tomwimmenhove/NerdClock/README.md

# NerdClock
7-Segment display using an LED and a 3-phase motor

See https://youtu.be/A6WD372-6BQ for a video of it running
