tomwimmenhove/NerdClock/hardware/Drawings/s-l1600 (UV LED).jpg

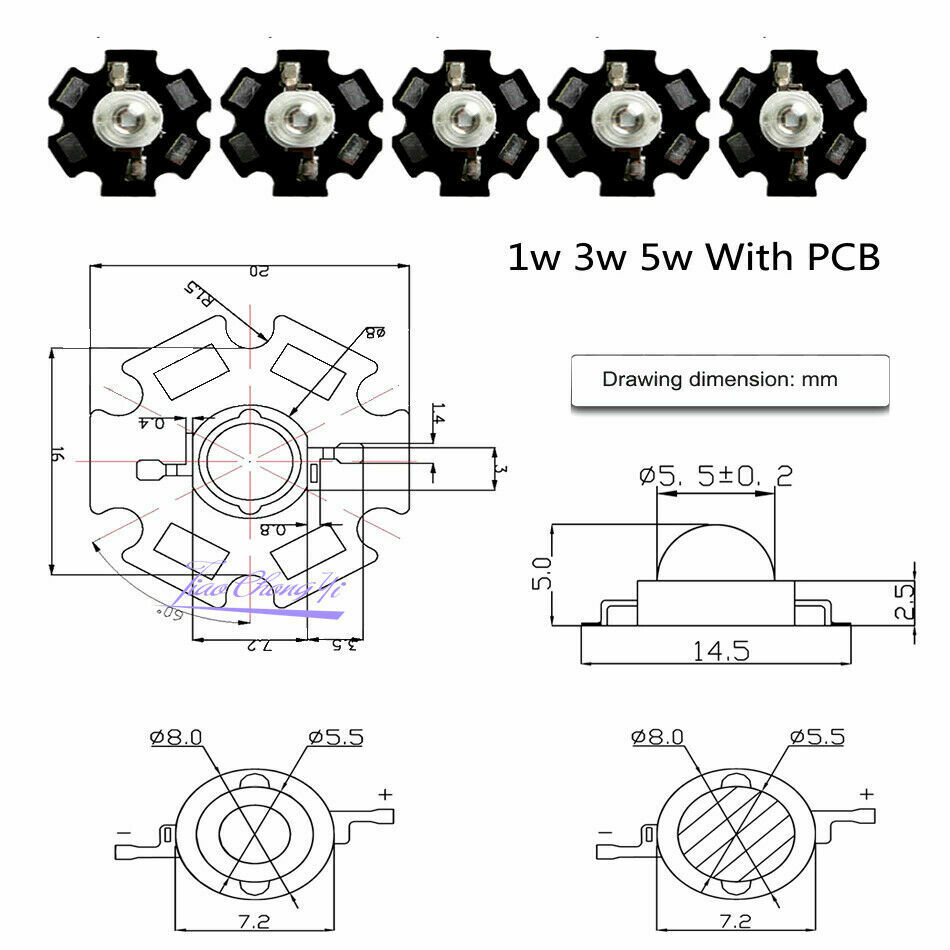
hardware/Drawings/s-l1600 (UV LED).jpg
