tomwimmenhove/NerdClock/hardware/NerdClock/NerdClock.kicad_pcb

## KiCad design hardware/NerdClock/NerdClock.kicad_pcb (2021-07-23)

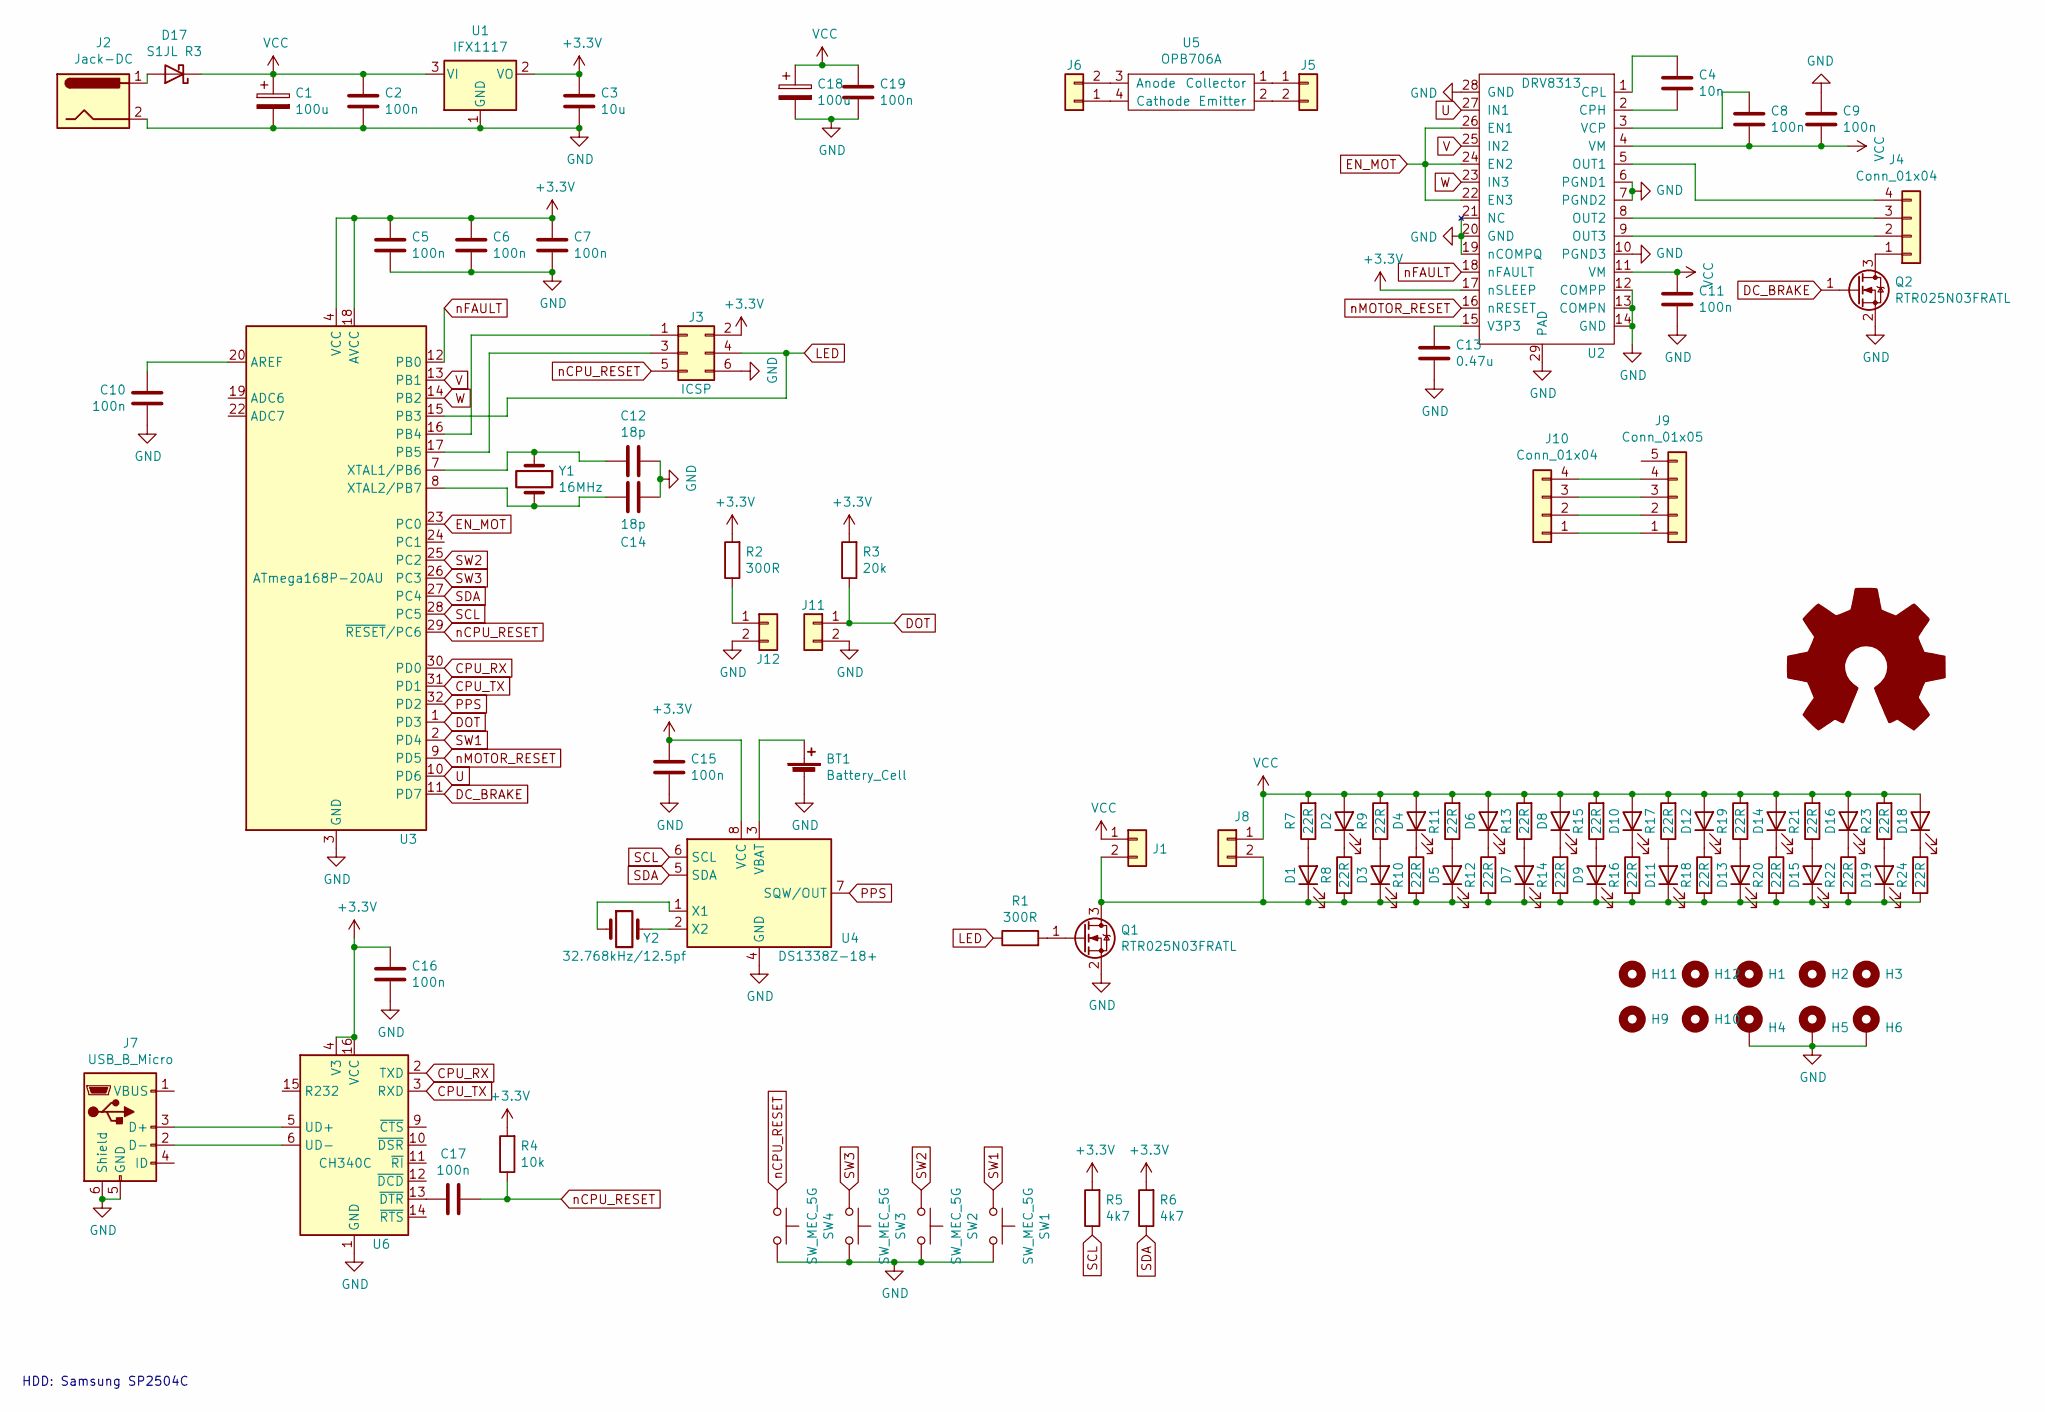
[picture p2: schematic NerdClock.sch]

Parts:
BT1: Battery_Cell; BatteryHolder_Keystone_1060_1x2032
C1, C18: 100u; CP_Elec_5x5.4
C2, C5, C6, C7, C8, C9, C10, C11, C15, C16, C17, C19: 100n; C_0603_1608Metric
C3: 10u; C_0603_1608Metric
C4: 10n; C_0603_1608Metric
C12, C14: 18p; C_0603_1608Metric
C13: 0.47u; C_0603_1608Metric
D1, D2, D3, D4, D5, D6, D7, D8, D9, D10, D11, D12, D13, D14, D15, D16, D18, D19: LED; WhiteLed1W
D17: S1JL R3; D_SMA
H1, H2, H3, H9, H10, H11, H12: MountingHole; MountingHole_3.2mm_M3
H4, H5, H6: MountingHole_Pad; MountingHole_3.2mm_M3_Pad_Via
J1, J5, J6, J11, J12: Conn_01x02; PinHeader_1x02_P2.54mm_Vertical
J2: Jack-DC; BarrelJack_Wuerth_6941xx301002
J3: ICSP; PinHeader_2x03_P2.54mm_Vertical
J4, J10: Conn_01x04; PinHeader_1x04_P2.54mm_Vertical
J7: USB_B_Micro; USB_Micro-B_Amphenol_10103594-0001LF_Horizontal
J8: Conn_01x02; PinHeader_2x01_P2.54mm_Vertical_SMD
J9: Conn_01x05; MotorConn
Q1, Q2: RTR025N03FRATL; SOT-23
R1, R2: 300R; R_0603_1608Metric
R3: 20k; R_0603_1608Metric
R4: 10k; R_0603_1608Metric
R5, R6: 4k7; R_0603_1608Metric
R7, R8, R9, R10, R11, R12, R13, R14, R15, R16, R17, R18, R19, R20, R21, R22, R23, R24: 22R; R_0603_1608Metric
SW1, SW2, SW3, SW4: SW_MEC_5G; SW_SPST_Omron_B3FS-100xP
U1: IFX1117; SOT-223-3_TabPin2
U2: DRV8313; HTSSOP-28-1EP_4.4x9.7mm_P0.65mm_EP3.4x9.5mm_ThermalVias
U3: ATmega168P-20AU; TQFP-32_7x7mm_P0.8mm
U4: DS1338Z-18+; SOIC-8_3.9x4.9mm_P1.27mm
U5: OPB706A
U6: CH340C; SOIC-16_3.9x9.9mm_P1.27mm
Y1: 16MHz; Crystal_SMD_ECS_CSM3X-2Pin_7.6x4.1mm
Y2: 32.768kHz/12.5pf; Crystal_C26-LF_D2.1mm_L6.5mm_Horizontal

Connections:
+3V3: C3.1, C5.1, C6.1, C7.1, C15.1, C16.1, J3.2, R2.2, R3.2, R4.2, R5.2, R6.2, U1.2 (VO), U2.17 (nSLEEP), U3.4 (VCC), U3.6 (VCC), U3.18 (AVCC), U4.8 (VCC), U6.4 (V3), U6.16 (VCC)
CPU_RX: U3.30 (PD0), U6.2 (TXD)
CPU_TX: U3.31 (PD1), U6.3 (RXD)
DC_BRAKE: Q2.1 (G), U3.11 (PD7)
DOT: J11.1, R3.1, U3.1 (PD3)
EN_MOT: U2.22 (EN3), U2.24 (EN2), U2.26 (EN1), U3.23 (PC0)
GND: BT1.2 (-), C1.2, C2.2, C3.2, C5.2, C6.2, C7.2, C9.1, C10.1, C11.2, C12.2, C13.2, C14.2, C15.2, C16.2, C18.2, C19.2, H4.1, H5.1, H6.1, J2.2, J3.6, J7.5 (GND), J7.6 (Shield), J11.2, J12.2, Q1.2 (S), Q2.2 (S), SW1.3 (B), SW1.4 (B), SW2.3 (B), SW2.4 (B), SW3.3 (B), SW3.4 (B), SW4.3 (B), SW4.4 (B), U1.1 (GND), U2.6 (PGND1), U2.7 (PGND2), U2.10 (PGND3), U2.12 (COMPP), U2.13 (COMPN), U2.14 (GND), U2.19 (nCOMPQ), U2.20 (GND), U2.21 (NC), U2.28 (GND), U2.29 (PAD), U3.3 (GND), U3.5 (GND), U3.21 (GND), U4.4 (GND), U6.1 (GND)
LED: J3.4, R1.1, U3.15 (PB3)
unnamed: BT1.1 (+), U4.3 (VBAT)
unnamed: C4.1, U2.1 (CPL)
unnamed: C4.2, U2.2 (CPH)
unnamed: C8.1, U2.3 (VCP)
unnamed: C10.2, U3.20 (AREF)
unnamed: C12.1, U3.7 (XTAL1/PB6), Y1.1
unnamed: C13.1, U2.15 (V3P3)
unnamed: C14.1, U3.8 (XTAL2/PB7), Y1.2
unnamed: C17.2, U6.13 (~DTR)
unnamed: D1.1 (K), D3.1 (K), D5.1 (K), D7.1 (K), D9.1 (K), D11.1 (K), D13.1 (K), D15.1 (K), D19.1 (K), J1.2, J8.2, Q1.3 (D), R8.2, R10.2, R12.2, R14.2, R16.2, R18.2, R20.2, R22.2, R24.2
unnamed: D1.2 (A), R7.1
unnamed: D2.1 (K), R8.1
unnamed: D3.2 (A), R9.1
unnamed: D4.1 (K), R10.1
unnamed: D5.2 (A), R11.1
unnamed: D6.1 (K), R12.1
unnamed: D7.2 (A), R13.1
unnamed: D8.1 (K), R14.1
unnamed: D9.2 (A), R15.1
unnamed: D10.1 (K), R16.1
unnamed: D11.2 (A), R17.1
unnamed: D12.1 (K), R18.1
unnamed: D13.2 (A), R19.1
unnamed: D14.1 (K), R20.1
unnamed: D15.2 (A), R21.1
unnamed: D16.1 (K), R22.1
unnamed: D17.2 (A), J2.1
unnamed: D18.1 (K), R24.1
unnamed: D19.2 (A), R23.1
unnamed: J3.1, U3.16 (PB4)
unnamed: J3.3, U3.17 (PB5)
unnamed: J4.1, Q2.3 (D)
unnamed: J4.2, U2.9 (OUT3)
unnamed: J4.3, U2.8 (OUT2)
unnamed: J4.4, U2.5 (OUT1)
unnamed: J5.1, U5.1 (Collector)
unnamed: J5.2, U5.2 (Emitter)
unnamed: J6.1, U5.4 (Cathode)
unnamed: J6.2, U5.3 (Anode)
unnamed: J7.2 (D-), U6.6 (UD-)
unnamed: J7.3 (D+), U6.5 (UD+)
unnamed: J9.1, J10.1
unnamed: J9.2, J10.2
unnamed: J9.3, J10.3
unnamed: J9.4, J10.4
unnamed: J12.1, R2.1
unnamed: Q1.1 (G), R1.2
unnamed: U4.1 (X1), Y2.1
unnamed: U4.2 (X2), Y2.2
PPS: U3.32 (PD2), U4.7 (SQW/OUT)
SCL: R5.1, U3.28 (PC5), U4.6 (SCL)
SDA: R6.1, U3.27 (PC4), U4.5 (SDA)
SW1: SW1.1 (A), SW1.2 (A), U3.2 (PD4)
SW2: SW2.1 (A), SW2.2 (A), U3.25 (PC2)
SW3: SW3.1 (A), SW3.2 (A), U3.26 (PC3)
U: U2.27 (IN1), U3.10 (PD6)
V: U2.25 (IN2), U3.13 (PB1)
VCC: C1.1, C2.1, C8.2, C9.2, C11.1, C18.1, C19.1, D2.2 (A), D4.2 (A), D6.2 (A), D8.2 (A), D10.2 (A), D12.2 (A), D14.2 (A), D16.2 (A), D17.1 (K), D18.2 (A), J1.1, J8.1, R7.2, R9.2, R11.2, R13.2, R15.2, R17.2, R19.2, R21.2, R23.2, U1.3 (VI), U2.4 (VM), U2.11 (VM)
W: U2.23 (IN3), U3.14 (PB2)
nCPU_RESET: C17.1, J3.5, R4.1, SW4.1 (A), SW4.2 (A), U3.29 (~RESET~/PC6)
nFAULT: U2.18 (nFAULT), U3.12 (PB0)
nMOTOR_RESET: U2.16 (nRESET), U3.9 (PD5)

Notes on the sheet:
HDD: Samsung SP2504C

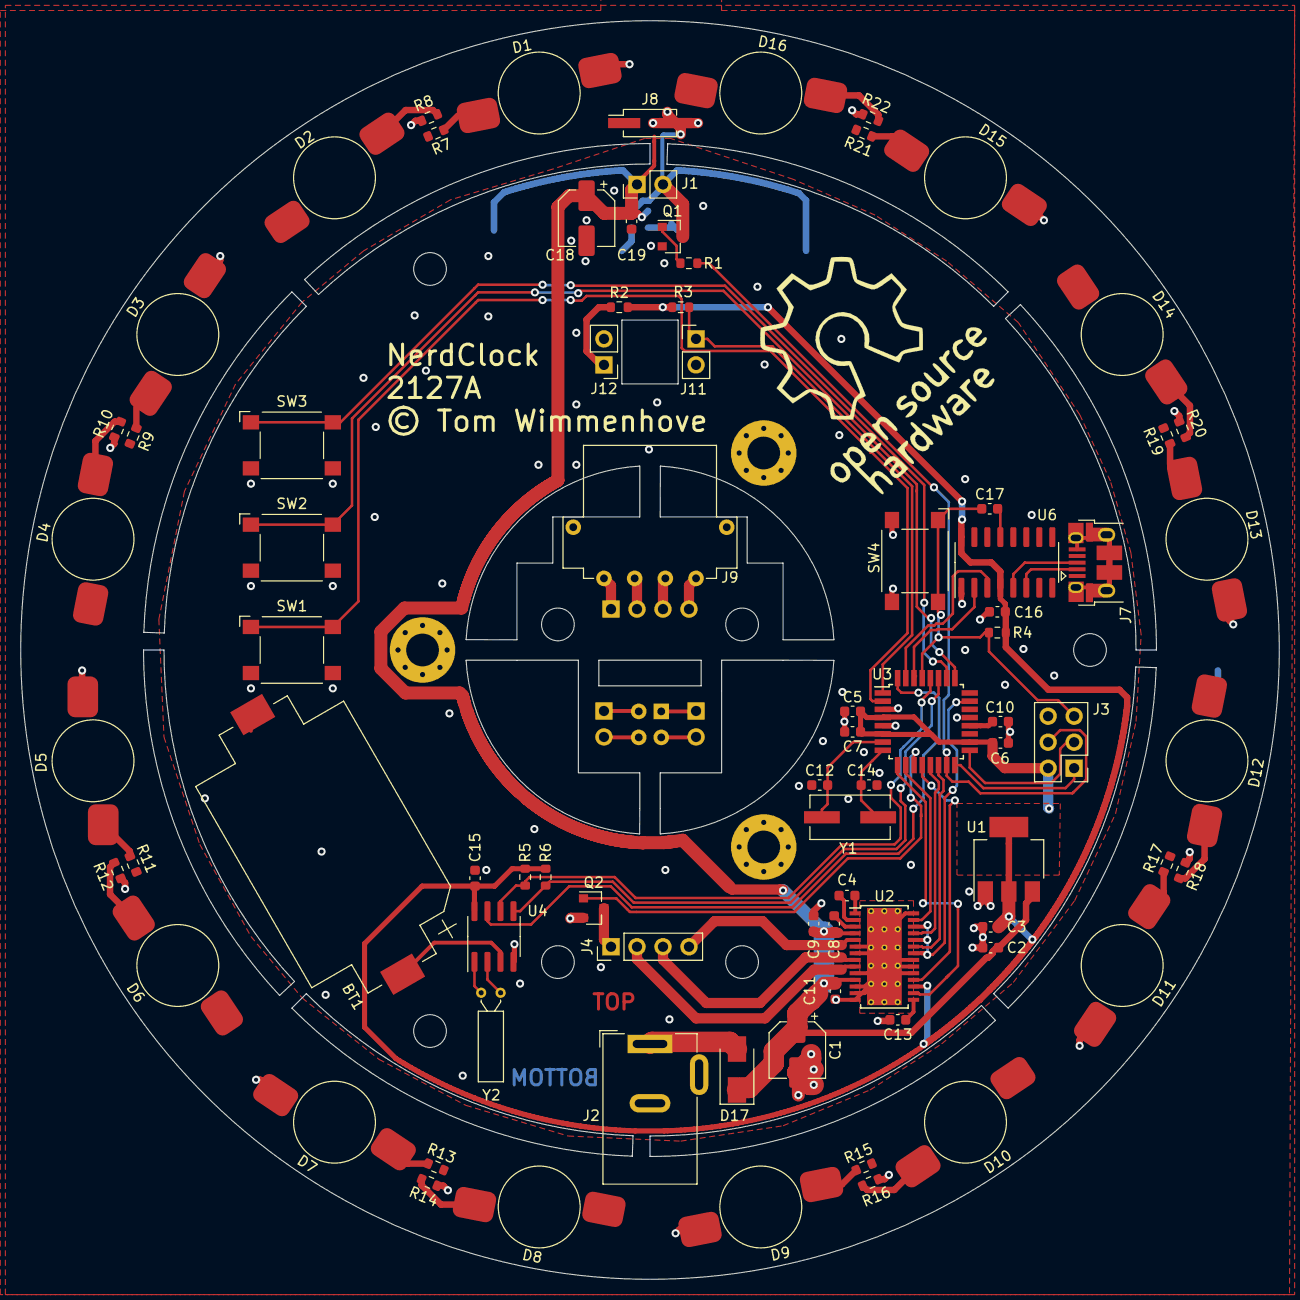
[picture p3: board NerdClock.kicad_pcb from above]

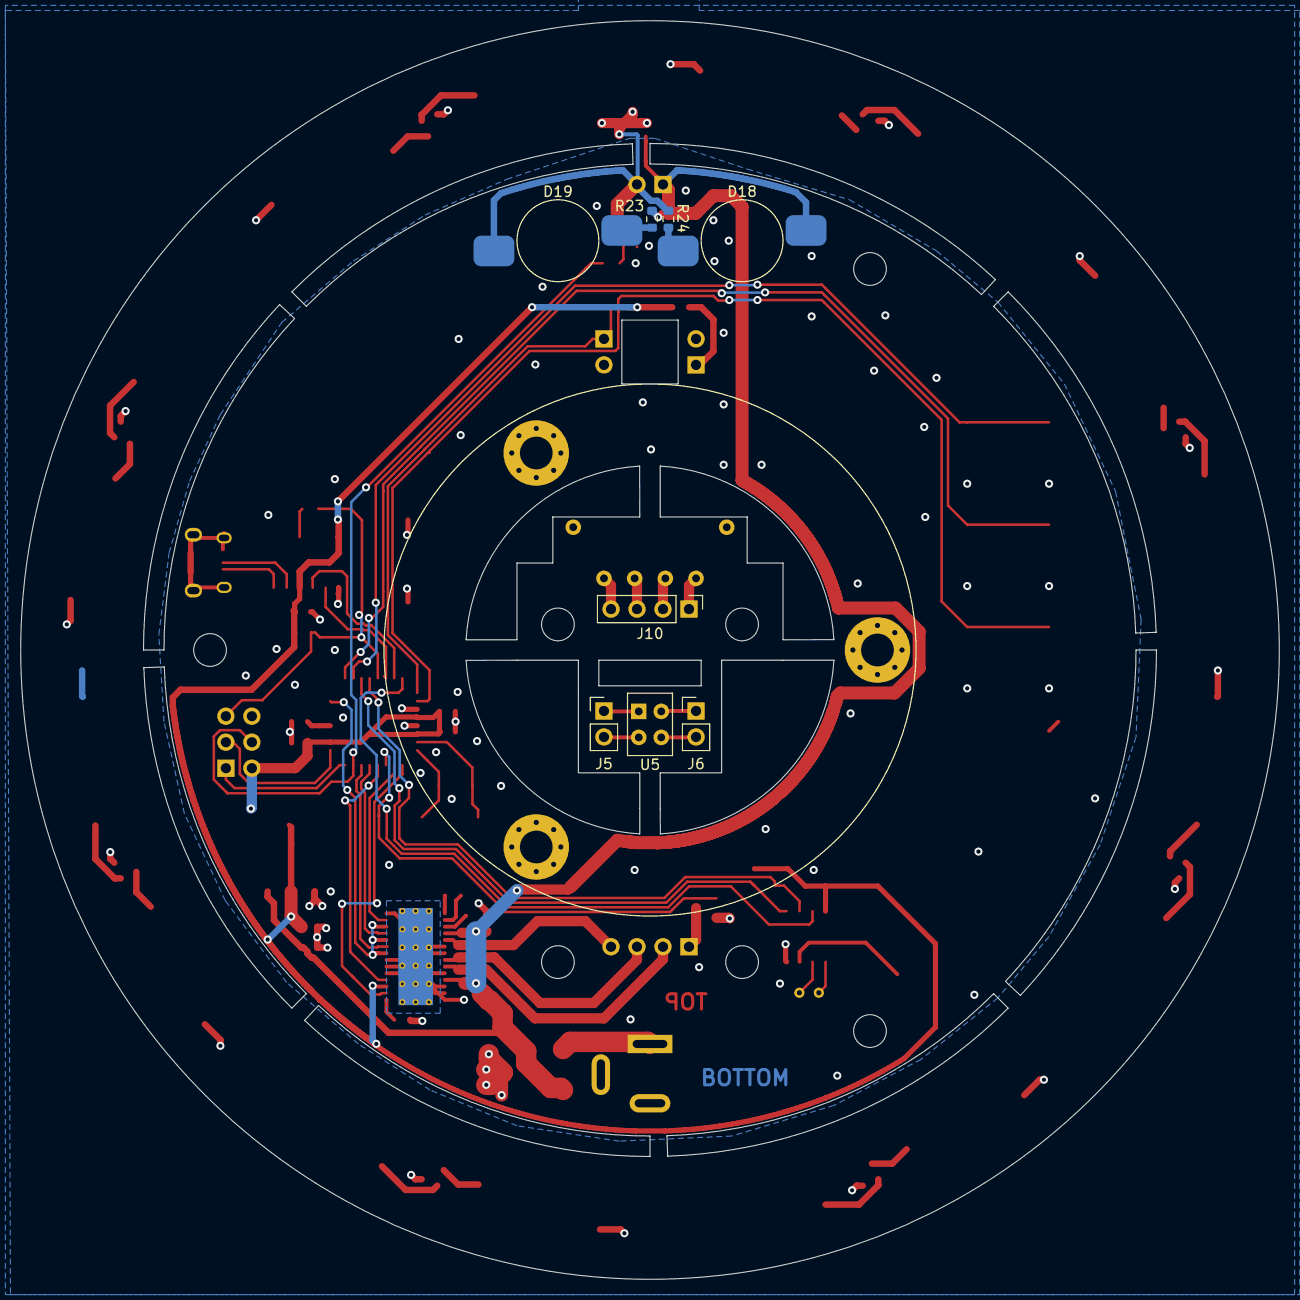
[picture p4: board NerdClock.kicad_pcb from below]

Board: 2 copper layers, 123.0 x 123.0 mm, 99 parts (8 on the bottom side), 70 nets.
