tomwimmenhove/NerdClock/firmware/src/sinetable.cpp

/*
 * SineTable.cpp
 *
 *  Created on: 5 Jul 2021
 *      Author: tom
 */

#include "sinetable.h"

const int8_t sinetable[256] PROGMEM = {
#if 0
  0x80,0x83,0x86,0x89,0x8c,0x8f,0x92,0x95,0x98,0x9c,0x9f,0xa2,0xa5,0xa8,0xab,0xae,
  0xb0,0xb3,0xb6,0xb9,0xbc,0xbf,0xc1,0xc4,0xc7,0xc9,0xcc,0xce,0xd1,0xd3,0xd5,0xd8,
  0xda,0xdc,0xde,0xe0,0xe2,0xe4,0xe6,0xe8,0xea,0xec,0xed,0xef,0xf0,0xf2,0xf3,0xf5,
  0xf6,0xf7,0xf8,0xf9,0xfa,0xfb,0xfc,0xfc,0xfd,0xfe,0xfe,0xff,0xff,0xff,0xff,0xff,
  0xff,0xff,0xff,0xff,0xff,0xff,0xfe,0xfe,0xfd,0xfc,0xfc,0xfb,0xfa,0xf9,0xf8,0xf7,
  0xf6,0xf5,0xf3,0xf2,0xf0,0xef,0xed,0xec,0xea,0xe8,0xe6,0xe4,0xe2,0xe0,0xde,0xdc,
  0xda,0xd8,0xd5,0xd3,0xd1,0xce,0xcc,0xc9,0xc7,0xc4,0xc1,0xbf,0xbc,0xb9,0xb6,0xb3,
  0xb0,0xae,0xab,0xa8,0xa5,0xa2,0x9f,0x9c,0x98,0x95,0x92,0x8f,0x8c,0x89,0x86,0x83,
  0x80,0x7c,0x79,0x76,0x73,0x70,0x6d,0x6a,0x67,0x63,0x60,0x5d,0x5a,0x57,0x54,0x51,
  0x4f,0x4c,0x49,0x46,0x43,0x40,0x3e,0x3b,0x38,0x36,0x33,0x31,0x2e,0x2c,0x2a,0x27,
  0x25,0x23,0x21,0x1f,0x1d,0x1b,0x19,0x17,0x15,0x13,0x12,0x10,0x0f,0x0d,0x0c,0x0a,
  0x09,0x08,0x07,0x06,0x05,0x04,0x03,0x03,0x02,0x01,0x01,0x00,0x00,0x00,0x00,0x00,
  0x00,0x00,0x00,0x00,0x00,0x00,0x01,0x01,0x02,0x03,0x03,0x04,0x05,0x06,0x07,0x08,
  0x09,0x0a,0x0c,0x0d,0x0f,0x10,0x12,0x13,0x15,0x17,0x19,0x1b,0x1d,0x1f,0x21,0x23,
  0x25,0x27,0x2a,0x2c,0x2e,0x31,0x33,0x36,0x38,0x3b,0x3e,0x40,0x43,0x46,0x49,0x4c,
  0x4f,0x51,0x54,0x57,0x5a,0x5d,0x60,0x63,0x67,0x6a,0x6d,0x70,0x73,0x76,0x79,0x7c
#else
	  0,   3,   6,   9,  12,  15,  18,  21,  24,  28,  31,  34,  37,  40,  43,  46,
      48,  51,  54,  57,  60,  63,  65,  68,  71,  73,  76,  78,  81,  83,  85,  88,
      90,  92,  94,  96,  98, 100, 102, 104, 106, 108, 109, 111, 112, 114, 115, 117,
     118, 119, 120, 121, 122, 123, 124, 124, 125, 126, 126, 127, 127, 127, 127, 127,

     127, 127, 127, 127, 127, 127, 126, 126, 125, 124, 124, 123, 122, 121, 120, 119,
     118, 117, 115, 114, 112, 111, 109, 108, 106, 104, 102, 100,  98,  96,  94,  92,
      90,  88,  85,  83,  81,  78,  76,  73,  71,  68,  65,  63,  60,  57,  54,  51,
      48,  46,  43,  40,  37,  34,  31,  28,  24,  21,  18,  15,  12,   9,   6,   3,

	  0,  -4,  -7, -10, -13, -16, -19, -22, -25, -29, -32, -35, -38, -41, -44, -47,
     -49, -52, -55, -58, -61, -64, -66, -69, -72, -74, -77, -79, -82, -84, -86, -89,
	 -91, -93, -95, -97, -99,-101,-103,-105,-107,-109,-110,-112,-113,-115,-116,-118,
	-119,-120,-121,-122,-123,-124,-125,-125,-126,-127,-127,-128,-128,-128,-128,-128,

	-128,-128,-128,-128,-128,-128,-127,-127,-126,-125,-125,-124,-123,-122,-121,-120,
	-119,-118,-116,-115,-113,-112,-110,-109,-107,-105,-103,-101, -99, -97, -95, -93,
 	 -91, -89, -86, -84, -82, -79, -77, -74, -72, -69, -66, -64, -61, -58, -55, -52,
	 -49, -47, -44, -41, -38, -35, -32, -29, -25, -22, -19, -16, -13, -10,  -7,  -4,
#endif
};
