tomwimmenhove/NerdClock/firmware/src/sinetable.h

/*
 * SineTable.h
 *
 *  Created on: 5 Jul 2021
 *      Author: tom
 */

#ifndef SRC_SINETABLE_H_
#define SRC_SINETABLE_H_

#include <stdint.h>
#include <avr/pgmspace.h>

extern const int8_t sinetable[];

#endif /* SRC_SINETABLE_H_ */
