tomwimmenhove/NerdClock/(commit log)

2021-07-08 Photo sensor keeps track of platters
2021-07-10 Added initial schemtaic
    [NerdClock.kicad_pcb, NerdClock.sch]
2021-07-11 Added breakout tabs
    [NerdClock.kicad_pcb]
2021-07-11 Put LEDs on the right side (wtffff)
    [NerdClock.kicad_pcb, NerdClock.sch]
2021-07-11 Routing backup
    [NerdClock.kicad_pcb, NerdClock.sch]
2021-07-11 Routing probably done?
    [NerdClock.kicad_pcb, NerdClock.sch]
2021-07-12 Fix all DRC errors
    [NerdClock.kicad_pcb, NerdClock.sch]
2021-07-12 Removed excessive vias and change battery angle
    [NerdClock.kicad_pcb]
2021-07-13 Added untested RTC code
    [NerdClock.kicad_pcb]
2021-07-16 Off to JLCPCB!
    [NerdClock-B_Cu.gbl, NerdClock-B_Mask.gbs, NerdClock-B_Paste.gbp, NerdClock-B_SilkS.gbo, NerdClock-Edge_Cuts.gm1, NerdClock-F_Cu.gtl, NerdClock-F_Mask.gts, NerdClock-F_Paste.gtp]
2021-07-23 Fixed hardware bug (polarity of IR led in relfection sensor
    [NerdClock.kicad_pcb, NerdClock.sch]
2021-07-23 Cleanup and stopepd using Tick to combat jitter
    [ds1338.cpp, main.cpp]
2021-07-24 DId we finally fix the fucking jitter?!
    [draw.cpp, draw.h, main.cpp]
2021-07-25 Fixed resistor value
2021-07-25 Rotate with buttons.
2021-09-11 WIP: create digit-pattern image in code. Print "1234"
2021-09-12 Added PCB clock face
    [Disk.kicad_pcb, Disk.sch]
2021-10-02 Some changes to disk pattern
    [Disk.kicad_pcb]
2021-10-02 Set the time using the buttons
