tomwimmenhove/NerdClock/(notices)

Notices in the files:
hardware/NerdClock/NerdClock.kicad_pcb:
© Tom Wimmenhove
